kein0r/TableWordClock/doc/WordClock_Chinese.docx

# 1 Variante 1:

c | h | à | è | r | s | h | í
y | ī | k | è | | f | ē | n
s | h | í | y | ī | 两 | è | r
s | ā | n | s | ì | l | i | ù
w | ǔ | | | j | i | ǔ
q | ī | b | ā | d | i | ǎ | n
y | ī | è | r | | s | h | í
k | è | b | à | n | f | ē | n

Schriftart: Consolas

Kleinste Breite für den Laser 0.15mm

Materialdicke mind. 2mm

Ein Modul ist knapp 38x38mm. Abstand zwischen zwei LED ca. 5mm

Ein Quadrat 9,5mm Letter 8x8mm

Cha er shi wu fen

--> 13

er shi yi er liang san se wu liu qi ba jiu dian

--> 35

yi er san shi ke ban wu fen

--> 20

total: 68

CHAERSHI

WUFEN

ER

SHIYISAN

ERSEWUQI

LIUBAJIU

DIAN

YIER

SANSHIKE

BANWUFEN

V2

CHAERSHI

FEN

ERSHI

SANLIANG

YIERSEWU

SANLIUQI

BAJIUDIAN
