kein0r/TableWordClock/doc/TableWordClock.FCStd

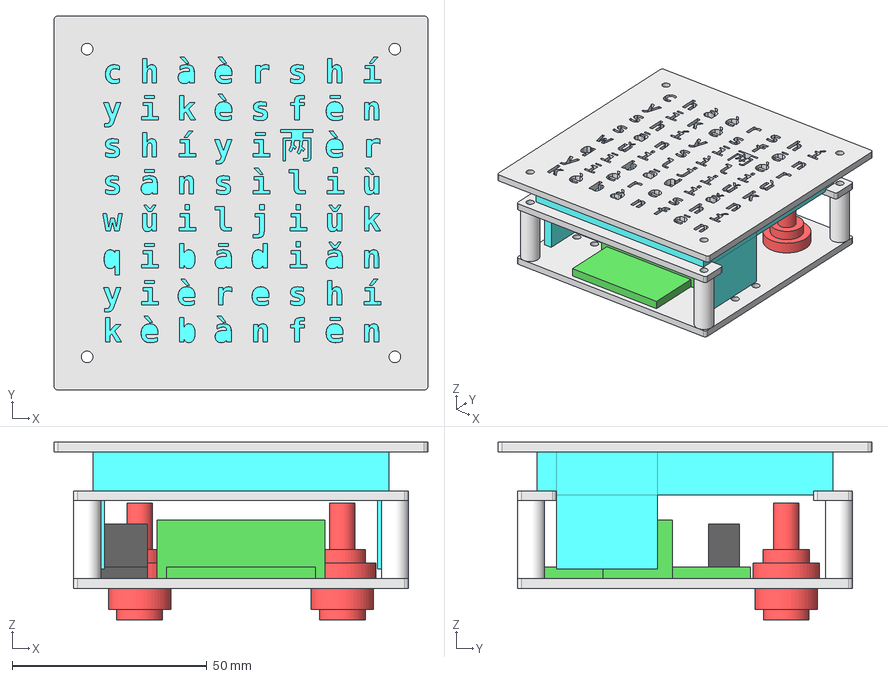
[picture p1: CAD file, 2014-09-23]
doc/TableWordClock.FCStd
96.0 x 96.0 x 45.6 mm
FrontWithLetterCut
ArduinoWithMountingHoles
LEDDisplayWithConnector
RTC
BackWithRTCMount
MinuteButton
HourButton
DisplayHolderLowerWithMountingHole
DisplayHolderUpperWithMountingHole
DistancePieceLL
DistancePieceLR
DistancePieceUL
DistancePieceUR
