kein0r/TableWordClock/doc/Production.dxf

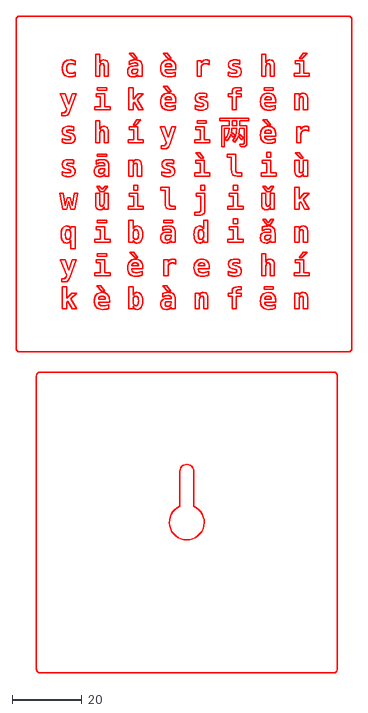
[picture p2: CAD file, 2014-08-31]
doc/Production.dxf
96.0 x 187.8
