kein0r/TableWordClock/(commit log)

2014-08-20 Initial version incl initial working display driver
2014-08-20 Added needed Timer1 library local
2014-08-20 Changed display driver to invert pixel Changed from MSD to LSB for shiftOut Code clean-up in TableWordClock.ino Works beside Timer not triggering display update
    [DisplayDriver.cpp, DisplayDriver.h, DisplayDriver_cfg.h, TableWordClock.ino]
2014-08-22 - Added switch "DISPLAYDRIVER_CLEARDISPLAYBEFOREUPDATE" to disable clear display before write to DisplayDriver - Renamed Timer1 to TimerOne and added example directory - Corrected BUG where compiler 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
    [DisplayDriver.cpp, DisplayDriver_cfg.h, TableWordClock.ino]
2014-08-23 Changed clear display pattern from 0xff to 0xffff Display driver will now only shift out those lines which are non-empty
2014-08-28 Removed deprecated versions from document Added laser cutting information
2014-08-31 Added initial drawing for fron plate
2014-08-31 Complete design incl. wall mount hole and back plane
2014-08-31 Generated 2D view of front and back Add dxf used for printing
    [Production.dxf]
2014-08-31 Replaced Production.dxf by two separate files
    [Back.dxf, Front.dxf]
2014-08-31 Deleted DXF files since they don't work Added 2D view to FreeCAD model Exported SVG files and sent
    [Back.dxf, Front.dxf]
2014-09-04 Removed remaining parts of time lib Added clock setting functionality via pin 2 and 3
2014-09-05 Move mounting holes 1,5mm towards outside
2014-09-05 Removed TimerOne Removed Timer1 ISR Display update will no be done directly after calculation in main loop
2014-09-05 Added ArduinoUno and mounting holes Added USB Cable fixation holes
2014-09-06 Added some comments for easier wiring
2014-09-06 Added Arduino Nano board documentation
2014-09-14 New Letter cut-out
2014-09-14 Corrected letters (removed inner part) Added Arduino and USB Cable mounting holes Added buttons for hour and minute set
    [TableWordClock.FCStd]
2014-09-15 Made holes for clock set buttons 16mm diameter
    [TableWordClock.FCStd]
2014-09-17 Switched back to ISR display update every 10m2 due to the fact that display update is very fast now
2014-09-17 Moved clear display back to original place to avoid ghost pictures Added clear display at end of update to make last line the same brightness as the others Implemented faster clear row function to re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
    [DisplayDriver.cpp, DisplayDriver.h]
2014-09-23 Added brackets for Display Reduced buttons to 12mm Added visuals for buttons, RTC and improved display visual Corrected position of back plane
    [TableWordClock.FCStd]
2014-09-24 Generated files to send for laser cutting
2014-10-12 clear IF for hour and minute buttons to fix a bug which made time always set during start-up Removed CLOCK_SET_PIN since not used
    [TableWordClock.ino]
2014-10-12 Added readFast function which will only read seconds, hours and minutes from RTC Fixed a bug which maked time jump from 11:39 to 255%3:40 thus, 3:40
    [DS3231RTC.cpp, DS3231RTC.h, TableWordClock.ino]
2014-10-12 Re-enabled timer ISR ;)
2014-12-14 Inlined a few functions (mainly ISR functions) for better performance Debounced buttons
2016-09-02 Added header file to make project compile with latest Arduino
